ZzzzzzS/YaoyaobangOnSTM32/(list of files, drawings)

Other design files:
Hardware/PCB1.PcbDoc
Hardware/Sheet2.SchDoc
Hardware/yaoyaobang.PrjPcb
Hardware/yaoyaobang/PCB1.PcbLib
Hardware/yaoyaobang/yaoyaobang.SCHLIB
