ZzzzzzS/YaoyaobangOnSTM32/Software/project.ioc

Mcu.UserName=STM32F103C8Tx
PB0.Signal=GPIO_Output
