ZzzzzzS/YaoyaobangOnSTM32/(commit log)

2018-04-06 1.0版本
    [PCB1.PcbDoc, Sheet2.SchDoc, yaoyaobang.PrjPcb]
2018-04-07 修改电路图部分丝印内容
    [PCB1.PcbDoc, yaoyaobang.PrjPcb]
2018-04-07 更新了readme
2018-10-22 增加bom表单
    [PCB1.PcbLib, Sheet2.CSV, yaoyaobang.PrjPcb, yaoyaobang.SCHLIB, yaoyaobang.xls]
